albertabionix/stepper-motor-driver/solidworks/assembly.SLDASM

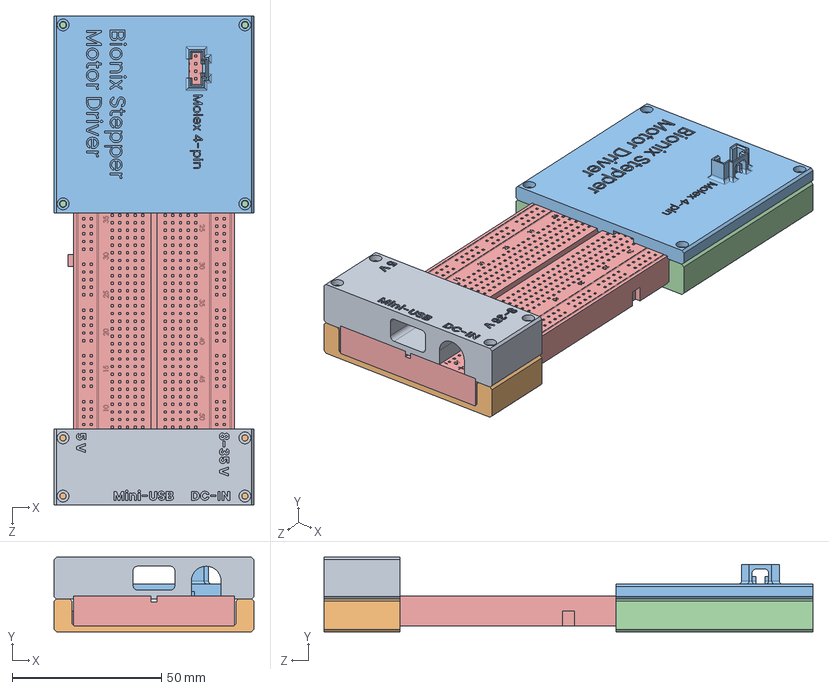
[picture p5: CAD file, 2026-09-29]
solidworks/assembly.SLDASM
67.0 x 25.0 x 164.0 mm
breadboard
left_bottom
left_top
right_bottom
right_top
