albertabionix/stepper-motor-driver/solidworks/left_bottom.SLDPRT

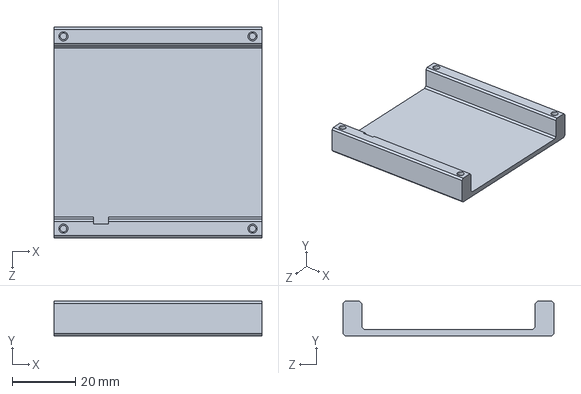
[picture p6: CAD file, 2026-09-29]
solidworks/left_bottom.SLDPRT
66.0 x 11.0 x 67.0 mm
