albertabionix/stepper-motor-driver/solidworks/right_bottom.SLDPRT

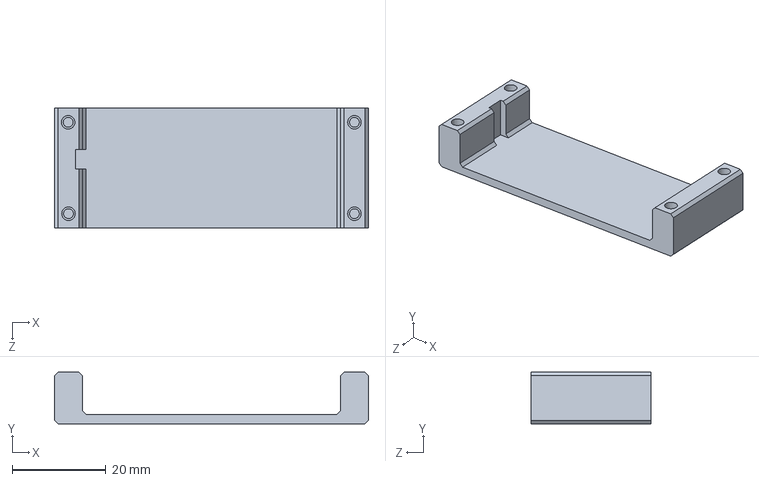
[picture p7: CAD file, 2026-09-29]
solidworks/right_bottom.SLDPRT
67.0 x 11.0 x 25.5 mm
