albertabionix/stepper-motor-driver/solidworks/right_top.SLDPRT

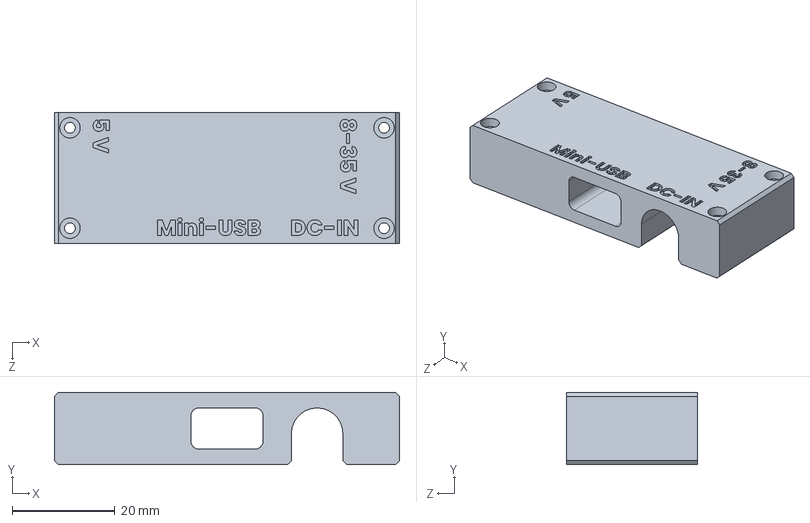
[picture p8: CAD file, 2026-09-29]
solidworks/right_top.SLDPRT
67.0 x 14.0 x 25.5 mm
