albertabionix/stepper-motor-driver/solidworks/breadboard.SLDPRT

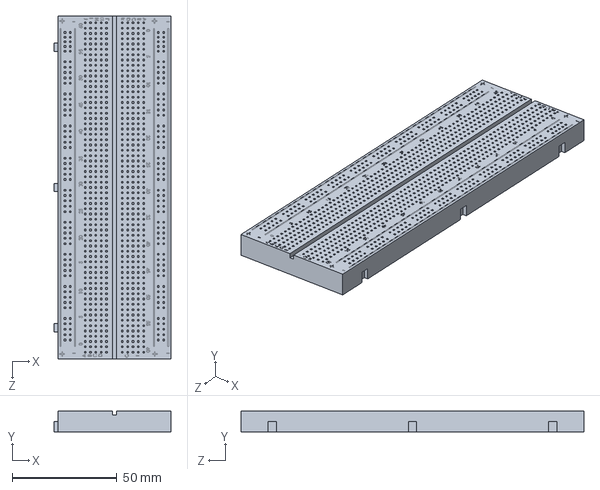
[picture p9: CAD file, 2026-09-29]
solidworks/breadboard.SLDPRT
55.8 x 10.0 x 164.0 mm
