albertabionix/stepper-motor-driver/solidworks/left_top.SLDPRT

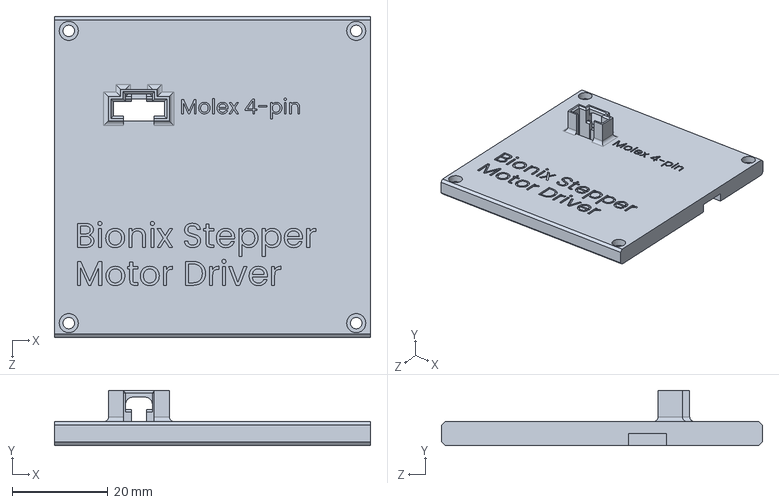
[picture p10: CAD file, 2026-09-29]
solidworks/left_top.SLDPRT
66.0 x 11.5 x 67.0 mm
